roccoagain/seed3-carrier/fabrication/2026-09-15-e7ddc60/drill-report.txt

Drill report for seed3-carrier.kicad_pcb
Created on 2026-09-15T15:13:16

Copper Layer Stackup:
    =============================================================
    L1 :  F.Cu                      front
    L2 :  B.Cu                      back

Drill file 'seed3-carrier-PTH.drl' contains
    plated through holes:
    =============================================================
    T1  0.300mm  0.0118"  (24 holes))
    T2  0.800mm  0.0315"  (6 holes))
    T3  1.000mm  0.0394"  (60 holes)  (with 5 slots)
    T4  1.100mm  0.0433"  (40 holes))
    T5  1.500mm  0.0591"  (8 holes))
    T6  3.000mm  0.1181"  (6 holes))

    Total plated holes count 144

Drill file 'seed3-carrier-NPTH.drl' contains
    unplated through holes:
    =============================================================
    T1  2.000mm  0.0787"  (4 holes))
    T2  3.000mm  0.1181"  (2 holes))

    Total unplated holes count 6
