roccoagain/seed3-carrier/fabrication/README.txt

Use 2026-09-15-e7ddc60/seed3-carrier-e7ddc60-JLCPCB.zip for manufacturing.
Superseded manufacturing packages have been removed; they remain available in Git history. See the current package README for mounting and verification notes.
The BOM is seed3-carrier-BOM.csv; no placement files are included.
The BOM now contains selected manufacturer part numbers, small-quantity DigiKey ordering numbers, product links, and quantities per board. Purchase Quantity excludes the already-owned Daisy module and bare PCB test pads.
Purchasing fields were added to the CSV on 2026-09-15; they are not all stored in the schematic. Preserve these fields when regenerating the BOM from KiCad. Availability was checked against DigiKey listings, which can be cached; recheck at checkout.
