roccoagain/seed3-carrier/(commit log)

2026-09-08 Add initial KiCad carrier project and ignore local history
    [seed3-carrier.kicad_pcb, seed3-carrier.kicad_sch]
2026-09-08 Complete carrier schematic with audio buffers, power, and display UART
    [seed3-carrier.kicad_sch]
2026-09-09 Refine audio filtering and bias values and add filtered pot controls
    [seed3-carrier.kicad_sch]
2026-09-09 Organize schematic into readable functional sections
    [seed3-carrier.kicad_sch]
2026-09-10 Add headphone output with switched line mute and assign footprints
    [seed3-carrier.kicad_sch]
2026-09-10 Replace input trimmer with matching front-panel potentiometers
    [seed3-carrier.kicad_pcb, seed3-carrier.kicad_sch]
2026-09-10 Save initial PCB placement checkpoint
    Capture preliminary component placement and schematic testpoint updates. Placement remains in progress; no copper traces or vias have been routed.
    [seed3-carrier.kicad_pcb, seed3-carrier.kicad_sch]
2026-09-10 Save PCB routing progress and Seed3 breakout headers
    [seed3-carrier.kicad_pcb, seed3-carrier.kicad_sch]
2026-09-10 Save ground pours and stitching via placement
    [seed3-carrier.kicad_pcb]
2026-09-10 Improve PCB routing and enforce 0.30 mm minimum track width
    [seed3-carrier.kicad_pcb]
2026-09-10 Reposition 5V connector and refine PCB routing
    [seed3-carrier.kicad_pcb]
2026-09-10 Remove ground stitching vias
    [seed3-carrier.kicad_pcb]
2026-09-10 Add volume and tone knob silkscreen labels
    [seed3-carrier.kicad_pcb]
2026-09-10 Add local ground stitching vias and adjust silkscreen labels
    [seed3-carrier.kicad_pcb]
2026-09-10 Add board revision, designer credits, and date to silkscreen
    [seed3-carrier.kicad_pcb]
2026-09-11 Replace FOOTPRINTS.md with schematic review TODO list
2026-09-14 Add reverse-polarity protection and switched input mute
    [seed3-carrier.kicad_pcb, seed3-carrier.kicad_sch]
2026-09-14 Expand display header to four pins with protected 5V
    Preserve GND and UART pin assignments and add protected +5V on pin 4. Reposition and label the header, reroute UART connections, and complete the power route with a short bottom-layer crossing beneath the buffered audio input. Refill copper zones.
    [seed3-carrier.kicad_pcb, seed3-carrier.kicad_sch]
2026-09-15 Improve silkscreen labels and use 0.15 mm text strokes
    [seed3-carrier.kicad_pcb]
2026-09-15 Move C14
    [seed3-carrier.kicad_pcb]
2026-09-15 Simplify silkscreen revision date to Sep 2026
    [seed3-carrier.kicad_pcb]
2026-09-15 Finalize potentiometer mounts and fabrication purchasing package
    [seed3-carrier-BOM.csv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]
2026-09-15 Resize carrier board and finalize component placement
    [seed3-carrier-B_Cu.gbl, seed3-carrier-B_Mask.gbs, seed3-carrier-B_Silkscreen.gbo, seed3-carrier-Edge_Cuts.gm1, seed3-carrier-F_Cu.gtl, seed3-carrier-F_Mask.gts, seed3-carrier-F_Silkscreen.gto, seed3-carrier-NPTH.drl]
2026-09-15 Regenerate fabrication outputs for board e7ddc60
    [seed3-carrier-B_Cu.gbl, seed3-carrier-B_Mask.gbs, seed3-carrier-B_Silkscreen.gbo, seed3-carrier-Edge_Cuts.gm1, seed3-carrier-F_Cu.gtl, seed3-carrier-F_Mask.gts, seed3-carrier-F_Silkscreen.gto, seed3-carrier-NPTH.drl]
2026-09-15 Update TODO to reflect completed circuit changes
2026-09-15 Remove superseded fabrication packages
    [seed3-carrier-B_Cu.gbl, seed3-carrier-B_Mask.gbs, seed3-carrier-B_Silkscreen.gbo, seed3-carrier-Edge_Cuts.gm1, seed3-carrier-F_Cu.gtl, seed3-carrier-F_Mask.gts, seed3-carrier-F_Silkscreen.gto, seed3-carrier-NPTH.drl]
